therickmatos/seguidor-fenolite/MAPA_PINOS.txt

MAPA DE PINOS v3 (placa roteada x2) - gerado de design.py

=== ESP32-C3 SuperMini (U1): fileira da frente (barra) e depois a de tras ===
  5V    -> NC      | NAO ligado
  GND   -> GND     | plano de GND
  3V3   -> 3V3     | saida do AMS1117 (U2) e pino 1 da barra (J2.1)
  IO4   -> C0      | C0 do mux 74HC4067 (ADC1), reto ate a barra
  IO3   -> S3      | S3 do mux, reto ate a barra
  IO2   -> S2      | S2 do mux, reto ate a barra (GPIO2 nao define o boot)
  IO1   -> S1      | S1 do mux, reto ate a barra
  IO0   -> S0      | S0 do mux, reto ate a barra
  IO5   -> BI_A    | BI_A -> U3.1 (motor ESQ). Hi-Z no reset; o pull-down interno do RZ7886 segura em 0
  IO6   -> FI_A    | FI_A -> U3.2 (motor ESQ) + R7 10k p/ GND (IO6/MTCK tem pull-up no reset)
  IO7   -> GATE_D  | GATE_D -> R1 220R -> gate do Q1 (turbina); R2 4k7 gate->GND
  IO8   -> MK_L    | MK_L sensor de marca ESQ (digital). Firmware: INPUT_PULLUP. Strapping: alto ao gravar pelo BOOT
  IO9   -> BTN     | BTN -> SW1 -> GND (e o proprio BOOT, pull-up interno)
  IO10  -> BI_B    | BI_B -> U4.1 (motor DIR)
  IO20  -> FI_B    | FI_B -> U4.2 (motor DIR) + R6 10k p/ GND (IO20/U0RXD tem pull-up no reset)
  IO21  -> MK_R    | MK_R sensor de marca DIR (digital). Firmware: INPUT_PULLUP

=== Sensores de marca (QRE1113GR, embaixo, na ponta dos bracos) ===
  pino 1 A <- R4/R5 470R <- VBAT  (LED ~12-15 mA com 2S)
  pino 2 K -> GND, pino 3 E -> GND, pino 4 C -> MK_L / MK_R (baixo = viu branco)

=== RZ7886 (U3 esquerdo, U4 direito) ===
  1 BI, 2 FI, 3 GND, 4 VCC(VBAT), 5/6 FO -> MA1/MB1, 7/8 BO -> MA2/MB2

=== NETLIST (rede -> pinos) ===
  3V3    : J2.1 U1.3V3 U2.2 U2.4 C2.1
  BI_A   : U1.IO5 U3.1
  BI_B   : U1.IO10 U4.1
  BTN    : U1.IO9 SW1.1
  C0     : J2.4 U1.IO4
  FI_A   : U1.IO6 U3.2 R7.1
  FI_B   : U1.IO20 U4.2 R6.1
  GATE   : Q1.1 R1.2 R2.1
  GATE_D : U1.IO7 R1.1
  GND    : J2.2 U1.GND U3.3 C3.2 C4.1 R7.2 U4.3 C5.2 C6.1 R6.2 SW1.2 Q1.2 R2.2 U2.1 C1.2 C2.2 J1.2 SL.2 SL.3 SR.2 SR.3
  LEDA_L : SL.1 R4.2
  LEDA_R : SR.1 R5.2
  MA1    : U3.6 U3.5 MA.1
  MA2    : U3.8 U3.7 MA.2
  MB1    : U4.6 U4.5 MB.2
  MB2    : U4.8 U4.7 MB.1
  MK_L   : U1.IO8 SL.4
  MK_R   : U1.IO21 SR.4
  S0     : J2.8 U1.IO0
  S1     : J2.7 U1.IO1
  S2     : J2.6 U1.IO2
  S3     : J2.5 U1.IO3
  TURB_N : TP.2 Q1.3
  VBAT   : U3.4 C3.1 C4.2 U4.4 C5.1 C6.2 TP.1 U2.3 C1.1 J1.1 R4.1 R5.1
