therickmatos/seguidor-fenolite/TABELA_EASYEDA_v3.md

# Seguidor fenolite v3 (dupla face) — dados para redesenhar no EasyEDA Pro

Origem = centro do furo da turbina; +x = direita; +y = frente do robô; vista de CIMA; mm; rotação em graus, anti-horário.
Face: "top" = lado dos componentes; "bottom" = SMD soldado embaixo da placa. Componentes PTH ficam sempre em cima.
Pads SMD de "bottom" estão em coordenadas vistas de CIMA (no EasyEDA, coloque o componente na camada Bottom com a mesma posição).

## Componentes

| Ref | Valor | Encapsulamento | Face | X (mm) | Y (mm) | Rot (°) |
|---|---|---|---|---|---|---|
| SW1 | KFC-A06 3x6x4.3 | KFC-A06 3x6x4,3 SMD 2T | top | 38.50 | 3.50 | 90 |
| C1 | 10uF | 1206 | top | 22.00 | -26.90 | 180 |
| C2 | 22uF | 1206 | top | 26.60 | -18.00 | 90 |
| C4 | 100nF | 1206 | bottom | -37.04 | 12.31 | 0 |
| C6 | 100nF | 1206 | bottom | 31.04 | -0.31 | 180 |
| U3 | RZ7886 | DIP-8 | top | -34.50 | 7.40 | 270 |
| U4 | RZ7886 | DIP-8 | top | 28.50 | 3.50 | 90 |
| C3 | 220uF | Radial Ø6,3 passo 2,5 | top | -26.00 | 11.50 | 180 |
| C5 | 220uF | Radial Ø6,3 passo 2,5 | top | 36.00 | 11.50 | 180 |
| U1 | ESP32-C3 | ESP32-C3 SuperMini (THT 2x8, fileiras a 15,24 mm) | top | 0.00 | 32.50 | 90 |
| J2 | barra | Barra 1x8 2,54 90° | top | 0.00 | 45.30 | 0 |
| SL | QRE1113GR | QRE1113GR | bottom | -68.00 | 4.50 | 0 |
| SR | QRE1113GR | QRE1113GR | bottom | 68.00 | 4.50 | 180 |
| R1 | 220R | 1206 | top | -28.00 | -20.50 | 90 |
| R2 | 4k7 | 1206 | top | -23.00 | -24.00 | 0 |
| R4 | 470R | 1206 | bottom | -45.00 | 2.40 | 0 |
| R5 | 470R | 1206 | bottom | 45.00 | 6.60 | 180 |
| R6 | 10k | 1206 | bottom | 27.23 | -2.95 | 90 |
| R7 | 10k | 1206 | bottom | -34.50 | 8.90 | 0 |
| U2 | AMS1117-3.3 | SOT-223 | top | 22.00 | -20.50 | 0 |
| Q1 | AO3400A | SOT-23 | top | -23.00 | -19.00 | 0 |
| MA | MOT ESQ | Ilhós p/ fio | top | -34.50 | 0.60 | 0 |
| MB | MOT DIR | Ilhós p/ fio | top | 28.50 | 12.50 | 0 |
| TP | TURBINA | Ilhós p/ fio | top | -26.50 | 3.50 | 90 |
| J1 | XT30PW-M | XT30PW-M | top | -33.50 | -32.00 | 180 |

## Pads (posição absoluta, camadas onde pode soldar)

| Pad | Rede | X | Y | Camadas |
|---|---|---|---|---|
| C1.1 | VBAT | 23.50 | -26.90 | cima |
| C1.2 | GND | 20.50 | -26.90 | cima |
| C2.1 | 3V3 | 26.60 | -19.50 | cima |
| C2.2 | GND | 26.60 | -16.50 | cima |
| C3.1 | VBAT | -24.75 | 11.50 | cima+baixo |
| C3.2 | GND | -27.25 | 11.50 | cima+baixo |
| C4.1 | GND | -35.54 | 12.31 | baixo |
| C4.2 | VBAT | -38.54 | 12.31 | baixo |
| C5.1 | VBAT | 37.25 | 11.50 | cima+baixo |
| C5.2 | GND | 34.75 | 11.50 | cima+baixo |
| C6.1 | GND | 29.54 | -0.31 | baixo |
| C6.2 | VBAT | 32.54 | -0.31 | baixo |
| J1.1 | VBAT | -31.00 | -32.00 | cima+baixo |
| J1.2 | GND | -36.00 | -32.00 | cima+baixo |
| J1.M1 | NC | -28.00 | -42.00 | cima+baixo |
| J1.M2 | NC | -39.00 | -42.00 | cima+baixo |
| J2.1 | 3V3 | -8.89 | 45.30 | cima+baixo |
| J2.2 | GND | -6.35 | 45.30 | cima+baixo |
| J2.3 | NC | -3.81 | 45.30 | cima+baixo |
| J2.4 | C0 | -1.27 | 45.30 | cima+baixo |
| J2.5 | S3 | 1.27 | 45.30 | cima+baixo |
| J2.6 | S2 | 3.81 | 45.30 | cima+baixo |
| J2.7 | S1 | 6.35 | 45.30 | cima+baixo |
| J2.8 | S0 | 8.89 | 45.30 | cima+baixo |
| MA.1 | MA1 | -37.04 | 0.60 | cima+baixo |
| MA.2 | MA2 | -31.96 | 0.60 | cima+baixo |
| MB.1 | MB2 | 27.00 | 12.50 | cima+baixo |
| MB.2 | MB1 | 30.00 | 12.50 | cima+baixo |
| Q1.1 | GATE | -23.95 | -20.10 | cima |
| Q1.2 | GND | -22.05 | -20.10 | cima |
| Q1.3 | TURB_N | -23.00 | -17.90 | cima |
| R1.1 | GATE_D | -28.00 | -22.00 | cima |
| R1.2 | GATE | -28.00 | -19.00 | cima |
| R2.1 | GATE | -24.50 | -24.00 | cima |
| R2.2 | GND | -21.50 | -24.00 | cima |
| R4.1 | VBAT | -43.50 | 2.40 | baixo |
| R4.2 | LEDA_L | -46.50 | 2.40 | baixo |
| R5.1 | VBAT | 43.50 | 6.60 | baixo |
| R5.2 | LEDA_R | 46.50 | 6.60 | baixo |
| R6.1 | FI_B | 27.23 | -1.45 | baixo |
| R6.2 | GND | 27.23 | -4.45 | baixo |
| R7.1 | FI_A | -33.00 | 8.90 | baixo |
| R7.2 | GND | -36.00 | 8.90 | baixo |
| SL.1 | LEDA_L | -66.00 | 3.60 | baixo |
| SL.2 | GND | -70.00 | 3.60 | baixo |
| SL.3 | GND | -70.00 | 5.40 | baixo |
| SL.4 | MK_L | -66.00 | 5.40 | baixo |
| SR.1 | LEDA_R | 66.00 | 5.40 | baixo |
| SR.2 | GND | 70.00 | 5.40 | baixo |
| SR.3 | GND | 70.00 | 3.60 | baixo |
| SR.4 | MK_R | 66.00 | 3.60 | baixo |
| SW1.1 | BTN | 38.50 | -0.10 | cima |
| SW1.2 | GND | 38.50 | 7.10 | cima |
| TP.1 | VBAT | -26.50 | 2.00 | cima+baixo |
| TP.2 | TURB_N | -26.50 | 5.00 | cima+baixo |
| U1.IO5 | BI_A | -8.89 | 24.88 | baixo |
| U1.5V | NC | -8.89 | 40.12 | baixo |
| U1.IO6 | FI_A | -6.35 | 24.88 | baixo |
| U1.GND | GND | -6.35 | 40.12 | baixo |
| U1.IO7 | GATE_D | -3.81 | 24.88 | baixo |
| U1.3V3 | 3V3 | -3.81 | 40.12 | baixo |
| U1.IO8 | MK_L | -1.27 | 24.88 | baixo |
| U1.IO4 | C0 | -1.27 | 40.12 | baixo |
| U1.IO9 | BTN | 1.27 | 24.88 | baixo |
| U1.IO3 | S3 | 1.27 | 40.12 | baixo |
| U1.IO10 | BI_B | 3.81 | 24.88 | baixo |
| U1.IO2 | S2 | 3.81 | 40.12 | baixo |
| U1.IO20 | FI_B | 6.35 | 24.88 | baixo |
| U1.IO1 | S1 | 6.35 | 40.12 | baixo |
| U1.IO21 | MK_R | 8.89 | 24.88 | baixo |
| U1.IO0 | S0 | 8.89 | 40.12 | baixo |
| U2.1 | GND | 19.70 | -23.60 | cima |
| U2.2 | 3V3 | 22.00 | -23.60 | cima |
| U2.3 | VBAT | 24.30 | -23.60 | cima |
| U2.4 | 3V3 | 22.00 | -18.20 | cima |
| U3.1 | BI_A | -30.69 | 11.21 | cima+baixo |
| U3.8 | MA2 | -30.69 | 3.59 | cima+baixo |
| U3.2 | FI_A | -33.23 | 11.21 | cima+baixo |
| U3.7 | MA2 | -33.23 | 3.59 | cima+baixo |
| U3.3 | GND | -35.77 | 11.21 | cima+baixo |
| U3.6 | MA1 | -35.77 | 3.59 | cima+baixo |
| U3.4 | VBAT | -38.31 | 11.21 | cima+baixo |
| U3.5 | MA1 | -38.31 | 3.59 | cima+baixo |
| U4.1 | BI_B | 24.69 | -0.31 | cima+baixo |
| U4.8 | MB2 | 24.69 | 7.31 | cima+baixo |
| U4.2 | FI_B | 27.23 | -0.31 | cima+baixo |
| U4.7 | MB2 | 27.23 | 7.31 | cima+baixo |
| U4.3 | GND | 29.77 | -0.31 | cima+baixo |
| U4.6 | MB1 | 29.77 | 7.31 | cima+baixo |
| U4.4 | VBAT | 32.31 | -0.31 | cima+baixo |
| U4.5 | MB1 | 32.31 | 7.31 | cima+baixo |

## Netlist

| Rede | Pinos |
|---|---|
| 3V3 | J2.1 U1.3V3 U2.2 U2.4 C2.1 |
| BI_A | U1.IO5 U3.1 |
| BI_B | U1.IO10 U4.1 |
| BTN | U1.IO9 SW1.1 |
| C0 | J2.4 U1.IO4 |
| FI_A | U1.IO6 U3.2 R7.1 |
| FI_B | U1.IO20 U4.2 R6.1 |
| GATE | Q1.1 R1.2 R2.1 |
| GATE_D | U1.IO7 R1.1 |
| GND | J2.2 U1.GND U3.3 C3.2 C4.1 R7.2 U4.3 C5.2 C6.1 R6.2 SW1.2 Q1.2 R2.2 U2.1 C1.2 C2.2 J1.2 SL.2 SL.3 SR.2 SR.3 |
| LEDA_L | SL.1 R4.2 |
| LEDA_R | SR.1 R5.2 |
| MA1 | U3.6 U3.5 MA.1 |
| MA2 | U3.8 U3.7 MA.2 |
| MB1 | U4.6 U4.5 MB.2 |
| MB2 | U4.8 U4.7 MB.1 |
| MK_L | U1.IO8 SL.4 |
| MK_R | U1.IO21 SR.4 |
| S0 | J2.8 U1.IO0 |
| S1 | J2.7 U1.IO1 |
| S2 | J2.6 U1.IO2 |
| S3 | J2.5 U1.IO3 |
| TURB_N | TP.2 Q1.3 |
| VBAT | U3.4 C3.1 C4.2 U4.4 C5.1 C6.2 TP.1 U2.3 C1.1 J1.1 R4.1 R5.1 |

## Contorno da placa (vértices em ordem; também em `placa_v3_contorno.dxf`)

(-45.00,-4.00) (-48.00,-4.00) (-48.00,0.00) (-72.00,0.00) (-72.00,9.00) (-48.00,9.50) (-48.00,15.00) (-20.00,15.00) (-16.75,18.24) (-14.50,18.24) (-14.50,27.30) (-12.40,27.30) (-12.40,37.70) (-14.50,37.70) (-14.50,47.00) (14.50,47.00) (14.50,18.24) (16.75,18.24) (20.00,15.00) (48.00,15.00) (48.00,9.50) (72.00,9.00) (72.00,0.00) (48.00,0.00) (48.00,-4.00) (45.00,-4.00) (40.00,-9.00) (40.00,-32.00) (32.70,-32.00) (29.20,-28.50) (22.00,-28.50) (20.50,-30.00) (-20.50,-30.00) (-22.00,-28.50) (-27.50,-28.50) (-27.50,-34.50) (-40.00,-34.50) (-40.00,-9.00)

## Furos e rasgos mecânicos (sem cobre)

| Função | X | Y | Furo |
|---|---|---|---|
| turbina | 0.00 | 0.00 | Ø17 mm |
| carcaça da turbina | 15.56 | 15.56 | Ø2 mm |
| carcaça da turbina | -15.56 | 15.56 | Ø2 mm |
| carcaça da turbina | 15.56 | -15.56 | Ø2 mm |
| carcaça da turbina | -15.56 | -15.56 | Ø2 mm |
| caixa de redução | 35.25 | -3.73 | Ø2 mm |
| caixa de redução | -35.25 | -3.73 | Ø2 mm |
| caixa de redução | 35.25 | -26.55 | Ø2 mm |
| caixa de redução | -35.25 | -26.55 | Ø2 mm |
| presilha da vareta | 43.75 | -1.75 | Ø2 mm |
| presilha da vareta | -43.75 | -1.75 | Ø2 mm |
| presilha da vareta | 43.75 | 10.75 | Ø2 mm |
| presilha da vareta | -43.75 | 10.75 | Ø2 mm |
| rasgo da bateria | 16.69 | -28.21 | 7 × 1 mm |
| rasgo da bateria | -16.69 | -28.21 | 7 × 1 mm |

## Vias (fio soldado nas duas faces; furo 0,8 mm, ilha Ø1,8 mm)

| # | Rede | X | Y | Função |
|---|---|---|---|---|
| V1 | 3V3 | 12.90 | 22.00 | troca de face |
| V2 | 3V3 | -3.81 | 42.71 | troca de face |
| V3 | BI_A | -11.15 | 20.55 | troca de face |
| V4 | BTN | 27.09 | -7.19 | troca de face |
| V5 | GATE_D | -28.00 | -24.18 | troca de face |
| V6 | GND | -46.36 | 8.06 | liga o GND de cima com o de baixo |
| V7 | GND | -12.64 | 24.62 | liga o GND de cima com o de baixo |
| V8 | MK_L | -58.27 | 5.49 | troca de face |
| V9 | MK_L | -25.67 | -5.57 | troca de face |

## Jumpers de fio (GND, por cima da placa)

"furo" = furo de 0,8 mm com ilha nas duas faces; "ponto" = ponto de solda Ø2 no plano de GND de cima (sem furo).

| # | Ponta A (X, Y) | Ponta B (X, Y) | Comprimento | Passa por cima de | Liga ao GND principal |
|---|---|---|---|---|---|
| JP1 | 17.84, -8.86 (ponto) | 14.72, -11.98 (ponto) | 4.4 mm | 3V3 | U4.3, C5.2, C6.1, R6.2, SW1.2, C2.2, SR.2, SR.3 |

## Trilhas (rede, camada, largura, pontos)

| Rede | Camada | Largura (mm) | Pontos (mm) |
|---|---|---|---|
| 3V3 | cima | 0.9 | (22.00,-23.60) (22.00,-18.20) |
| 3V3 | cima | 0.9 | (22.00,-18.20) (24.85,-18.20) |
| 3V3 | cima | 0.9 | (26.60,-19.50) (26.15,-19.50) (24.85,-18.20) |
| 3V3 | cima | 0.9 | (22.00,-18.20) (19.15,-18.20) |
| 3V3 | cima | 0.9 | (12.90,22.00) (12.66,21.76) (12.66,-6.71) (19.15,-13.20) (19.15,-18.20) |
| 3V3 | baixo | 0.9 | (-3.81,40.12) (-3.81,34.50) (12.90,34.50) (12.90,22.00) |
| 3V3 | cima | 0.9 | (-3.81,42.71) (-8.89,42.71) (-8.89,45.30) |
| 3V3 | baixo | 0.9 | (-3.81,40.12) (-3.81,42.71) |
| BI_A | cima | 0.8 | (-30.69,11.21) (-28.46,13.44) (-20.05,13.44) (-19.36,12.75) (-14.41,12.75) (-11.15,16.01) (-11.15,20.55) |
| BI_A | baixo | 0.8 | (-8.89,24.88) (-11.15,22.62) (-11.15,20.55) |
| BI_B | baixo | 0.8 | (3.81,24.88) (3.81,18.82) (22.94,-0.31) |
| BI_B | baixo | 0.8 | (24.69,-0.31) (22.94,-0.31) |
| BTN | baixo | 0.8 | (27.09,-7.19) (1.27,18.63) (1.27,24.88) |
| BTN | cima | 0.8 | (38.50,-2.00) (38.66,-2.17) (38.66,-5.15) (36.62,-7.19) (27.09,-7.19) |
| BTN | cima | 0.8 | (38.50,-0.10) (38.50,-2.00) |
| C0 | baixo | 0.8 | (-1.27,45.30) (-1.27,40.12) |
| FI_A | baixo | 0.8 | (-6.35,24.88) (-6.35,20.81) (-18.26,8.90) (-33.00,8.90) |
| FI_A | baixo | 0.8 | (-33.00,8.90) (-33.00,10.75) |
| FI_A | baixo | 0.8 | (-33.00,10.75) (-33.23,10.98) (-33.23,11.21) |
| FI_B | baixo | 0.8 | (27.23,-0.31) (27.23,1.54) |
| FI_B | baixo | 0.8 | (6.35,24.88) (6.35,18.79) (23.60,1.54) (27.23,1.54) |
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
| VBAT | cima | 1.1 | (24.30,-23.60) (24.30,-26.10) (23.50,-26.90) |
| VBAT | baixo | 1.1 | (-26.50,2.00) (-26.50,-0.05) |
| VBAT | baixo | 1.1 | (37.25,11.50) (37.25,9.45) |
| VBAT | baixo | 1.1 | (43.50,6.60) (41.75,6.60) |
| VBAT | baixo | 1.1 | (41.75,6.60) (38.90,9.45) (37.25,9.45) |
