therickmatos/seguidor-fenolite/imagens/placa_v2_nariz_zoom.png

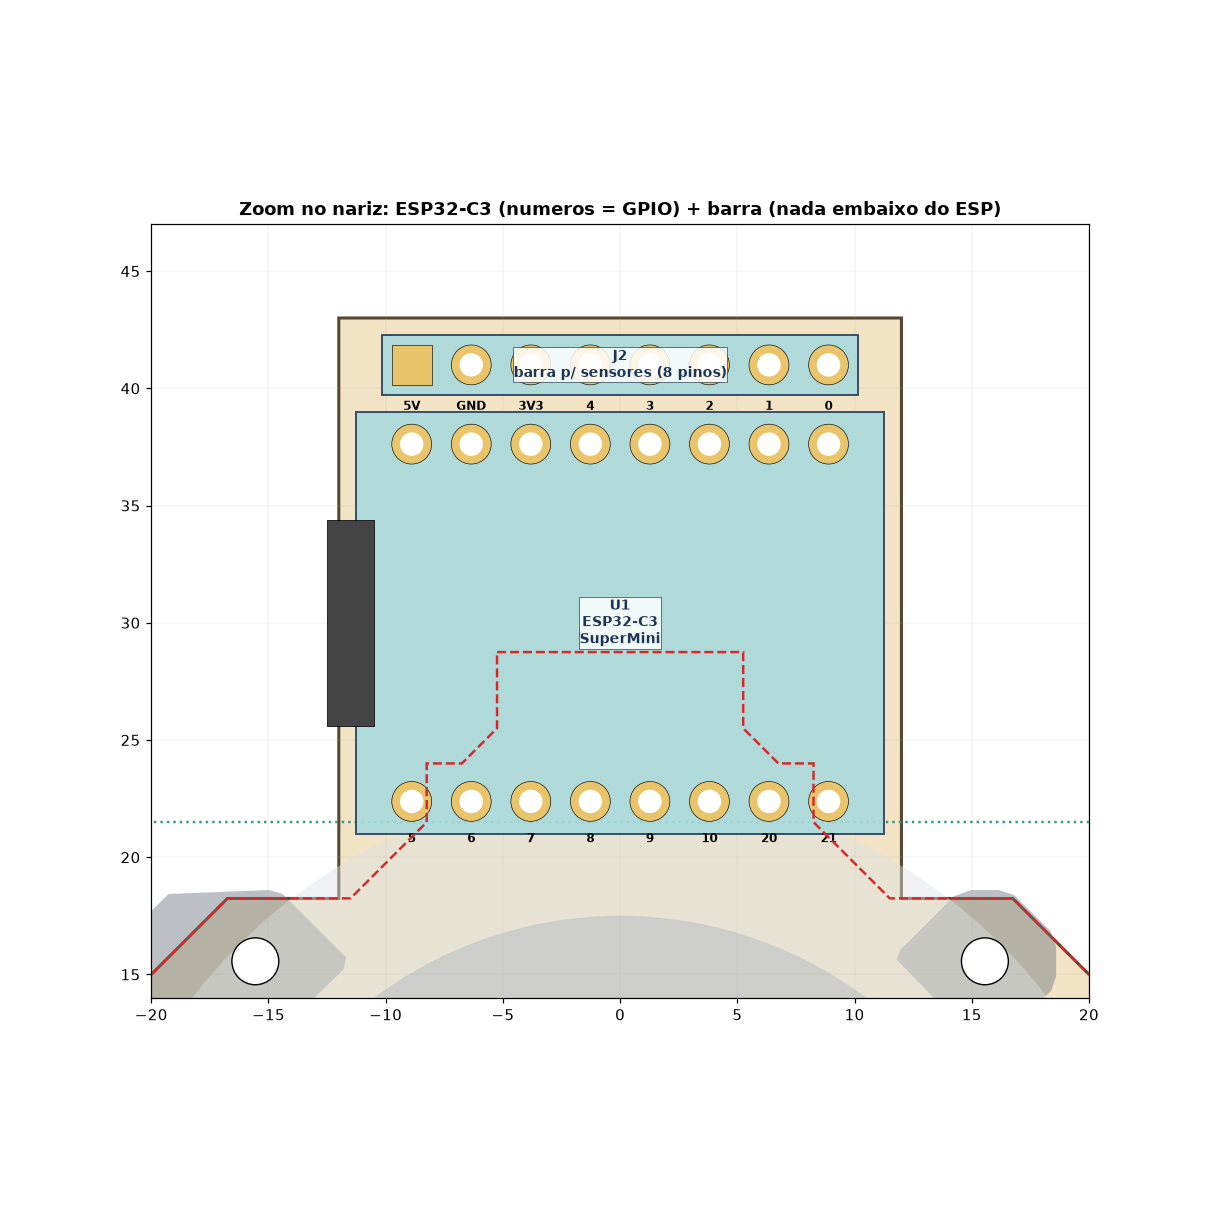
imagens/placa_v2_nariz_zoom.png
