therickmatos/seguidor-fenolite/imagens/placa_v2_posicionamento.png

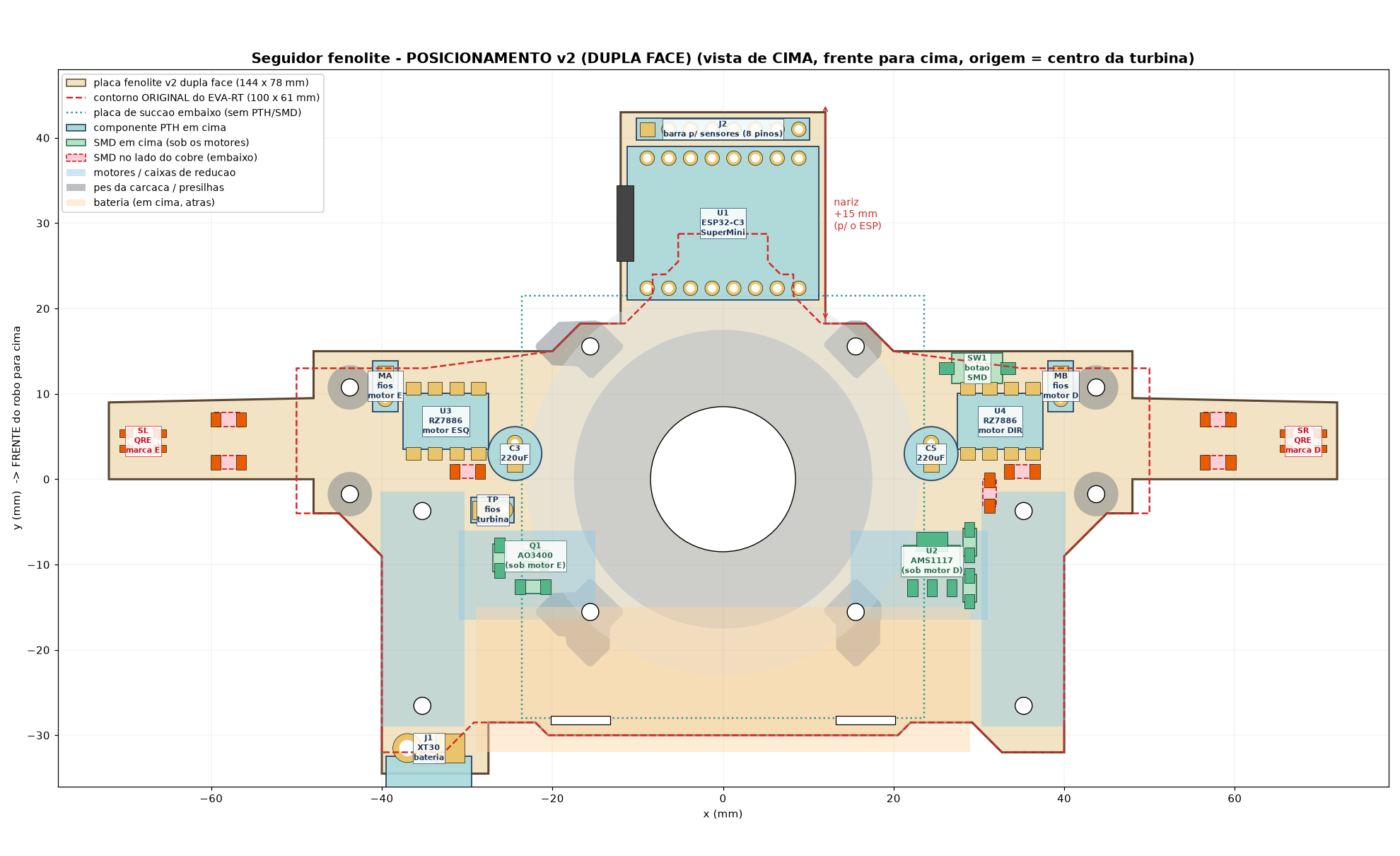
imagens/placa_v2_posicionamento.png
