therickmatos/seguidor-fenolite/placa_v3_contorno.dxf

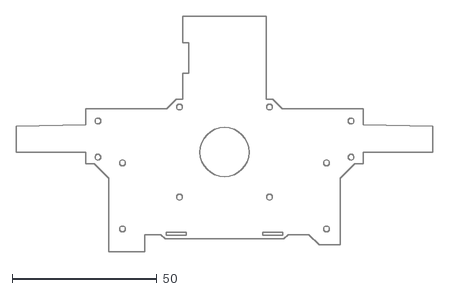
[picture p6: CAD file, 2026-10-28]
placa_v3_contorno.dxf
144.0 x 81.5
