therickmatos/seguidor-fenolite/(list of files, drawings)

Other design files:
roteamento/x2.dsn
