therickmatos/seguidor-fenolite/(commit log)

2026-10-28 Posicionamento v1 do seguidor em fenolite (para aprovacao)
2026-10-28 Posicionamento v2: dupla face, SMD sob os motores, XT30 no canto traseiro
2026-10-28 Editor de posicionamento interativo (HTML unico, sem dependencias)
2026-10-28 v3 roteada: dupla face, DRC 0, GND sem ilhas (2 vias de GND + 1 jumper)
    [placa_v3_contorno.dxf, x2.dsn]
